Karanneel/topology-optimisation/cad/baseline/tooling_arm_baseline_v02.step

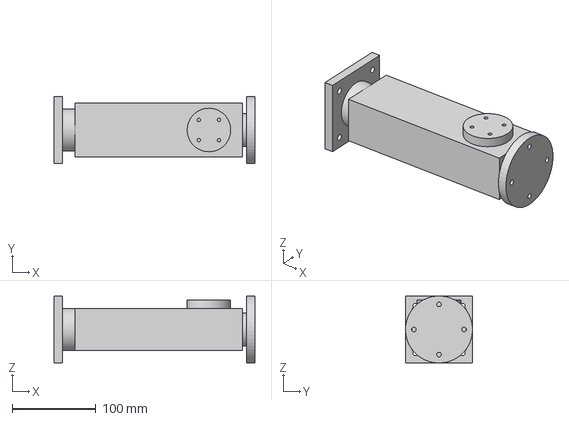
[picture p19: CAD file, 2026-10-25]
cad/baseline/tooling_arm_baseline_v02.step
240.0 x 80.0 x 80.0 mm
