Karanneel/topology-optimisation/results/tooling_arm_metrics.csv

geometry | case | nodes | pad_nodes | flange_nodes | max_disp_mm | pad_uz_mm | flange_ux_mm | flange_twist_deg | compliance_J | peak_vm_MPa | vm_p999_MPa | react_nodes | Fx | Fy | Fz | Mx | My | Mz
baseline_4mm | A | 23244 | 513 | 642 | 0.022339067 | -0.015626444 | 5.4683713e-05 | 2.8102151e-07 | 0.0039066109 | 3.2511852 | 2.9028154
baseline_4mm | B | 23244 | 513 | 642 | 0.0082948719 | 5.0386659e-05 | -0.00060407573 | 0.011585629 | 0.0050341997 | 4.4917675 | 3.3792524
baseline | A | 71589 | 556 | 994 | 0.02277206 | -0.015875455 | -2.1296178e-05 | -2.7699545e-07 | 0.0039688636 | 3.8600045 | 3.049098 | 1122 | 4.2290347e-05 | 0.00010436818 | 249.99961 | -0.00014662643 | -46.249548 | -0.00025442403
baseline | B | 71589 | 556 | 994 | 0.0084927873 | 9.780322e-05 | -0.00060861547 | 0.011868038 | 0.0051538568 | 4.6174005 | 3.517029 | 1122 | 300 | 2.5712418e-06 | -2.7935157e-06 | -24 | 0.00014779798 | -8.5059646e-06
handling | A | 52635 | 390 | 873 | 0.033607556 | -0.021648302 | -0.00052005758 | -6.503137e-05 | 0.0054120755 | 4.2618605 | 3.3463899 | 1131 | 0.00010115452 | -0.0001218983 | 250.00004 | 0.0031101654 | -46.215438 | -4.6815651e-06
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
